Nir552/PiezoMic/hardware/amplifier_circuit.asc

AMP: npn; 2N2222
BUFFER: npn; 2N2222
C1: cap; 10µ
C2: cap; 10n
C3: cap; 10n
C4: cap; 10µ
C5: cap; 10n
PHIZO: voltage; SINE(0 0.02 1000); AC 1
R1: res; 220
R2: res; 10K
R3: res; 1Meg
R4: res; 1Meg
R5: res; 28.85K
R6: res; 10K
R7: res; 1.524K
R8: res; 100
R9: res; 1K
vcc: voltage; 3.3v
Named nets: 0, IN, V_CLEAN, AMP_OUT, BUFF_OUT, TO_ADC1
.ac dec 100 10 100k
.tran 0 20m 0 1u
