Nir552/PiezoMic/(commit log)

2026-03-22 Initial release: piezo microphone with ESP32 and DSP pipeline
2026-06-28 Enhance documentation for piezo microphone project
    Updated project documentation with detailed descriptions of the microphone system, including analog and digital stages, DSP pipeline, and hardware requirements.
